pepiuspl/ArduinoR4wifi-Access-control/(commit log)

2026-05-26 Add access control sketch for Arduino IoT Cloud
2026-06-10 Added arduino-cli library index initialization step
2026-06-12 improvements, email reset logic rework
    [access_control.ino]
2026-06-12 File name .bin correction
    [access_control.ino]
2026-06-13 OTA rework open lock app synchro rework
    [access_control.ino]
2026-06-14 ESP32 v2.9.6
2026-06-14 ESP32 cleaned up
2026-06-14 EPS32 new device assign logic correction
    [access_control.ino]
2026-06-14 v2.9.7 - Cloud Solution ESP32
2026-06-14 compile-ESP32 add
2026-06-15 compiler correct ESP32
2026-06-15 pin correct
2026-06-15 high low change relay pin
2026-06-15 pin correction relay
2026-06-15 rfid, relay rework
2026-06-15 OTA Rework password show
    [access_control.ino]
2026-06-17 Sprint: lock state fix, livelier buzzer, offline mode, OTA
    [access_control.ino]
2026-06-23 relay fix
2026-06-23 IO2 pin change
2026-06-23 high-low change relay
2026-06-23 output input correction low high correction
    [access_control.ino]
2026-06-23 relay debug
2026-06-23 relay fixes
2026-06-29 keypad debug + fix
    [access_control.ino]
2026-07-03 heartbeat buzzer//relay activate/deactivate
2026-07-03 regex pin correction
2026-07-03 JWT token regex logic correction
    PIN logic correction
2026-07-03 OTA logic rework -- status bar correction Possible update check rework
    [access_control.ino]
2026-07-03 relay correction
2026-07-03 relay rework
2026-07-04 relay pin change
2026-07-04 moving to domain, rate limits, NPM introduced, performance correction
    [access_control.ino]
2026-07-04 settings wifi change rework/debug
    [access_control.ino]
2026-07-06 log button + MAC
2026-07-08 pin display fix
2026-07-08 OLED PIN message correction
    [access_control.ino]
2026-07-10 relay change
2026-07-30 added schedule, rotation PIN, guest mode, expiry date PIN, multidevice operation
2026-07-30 Adjusting card template to fit PIN
2026-08-01 logs filtering, cards change, schedule of use for pin and cards
2026-08-02 deciding length opening // relay fix
    [access_control.ino]
2026-08-03 denied screen + red LED
2026-08-13 Adding teams tab in app, invitations logic, super-admin logic,naming devices, invitations via email and code, deleting current setup - purging the device
2026-08-13 LIttle FS introduction instead of EEPROM, data retention, prep for licensing
    [partitions.csv]
2026-08-17 RFID pin correction
2026-08-17 RFID correction, handshake poll time short
    [access_control.ino]
2026-08-17 rfid reading speed fix
    [access_control.ino]
2026-08-17 adding reset button
2026-08-17 api/data correction, release_id addition
    [access_control.ino]
2026-08-18 reading cards fix, schedule fix
    [access_control.ino]
2026-09-14 firmware: offline licence token (dormant), BOARD_PCB_REV02 build flag; licensekey.js moved to tools/
    - OFL1 signed licence token (parseLicenseToken/applyLicenseToken, NVS ctrlsec/oflic), OFFLINE_FREE_CARDS=2 enforced in saveNewCard, learning flow handles cap
    - BOARD_PCB_REV02: KP_COL3 on IO2 for the custom PCB rev 0.2 (default 0 = dev kit, IO12)
    - tools/licensekey.js: online codes + offline tokens (offline mode not sold since 2026-09-14); deploy.sh packs it from tools/
    - .gitignore: licence/firmware signing keys never in repo
2026-09-14 docs: documentation audit 2026-09-14 — legal docs, website and licensing model aligned with code
    - LICENSING §3.4: downgrade = deactivate excess cards/PINs per client choice, owner card never locked, 90 days then delete; §3.3 Gold monthly; §3.5 offline licence dormant (offline = free tier only)
    - README §3.7 limit enforcement, §5.12 dormant offline licence
    - privacy policy + terms: service access (48 h, on-site code), controller/processor roles, offline mode, retention 15/45/90, backups 30/90, OVH mail relay, EAS, in-app export/deletion, warranty 24/12, packages and expiry, OTA, UID cloning notice, art. 38(13) consent, ODR removed; pre-release note
    - website: cloud optional (online/of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
2026-09-14 docs+site: audit stages 2-4 — legal docs, website copy, README aligned with code
    - privacy policy/terms: roles, offline mode, retention 15/45/90 + 90-day credential hold, backups 30/90, OVH/EAS/NTP/GitHub processors, in-app export/deletion, warranty 24/12, packages, expiry, OTA, UID cloning, art. 38(13), ODR removed, pre-release note
    - website: pre-launch bar, online/offline positioning, Polish product, Node spec rebuilt around one-controller strengths + security card, packages as cards+PINs without device limit, company data on contact page
    - LICENSING §3.4 90-day deletion + reminders (to implement), §3.5 offline licence dormant, Gold monthly; README §3.1b/§3.2/§3.6/§4.1/§5.1b/§9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
2026-09-14 firmware: bump app_version to v3.2.0 (offline licence dormant, BOARD_PCB_REV02 flag, tamper comment)
2026-09-14 server: licence lifecycle — expiry reminders (T-7/T-1), 10-day deletion warning, delete package-locked credentials after 90 days
    - migrations: license_locked_at, license_delete_notice_sent (cards/PINs), license_notice_valid_until/stage (accounts)
    - enforceLicenseLimits stamps license_locked_at on lock, clears on restore
    - runLicenseLifecycle() daily: e-mail+push reminders, warning 10 days before deletion, delete after LOCKED_CREDENTIAL_DAYS (cards also get D|uid so the device forgets them); owner card/PIN never affected
    - docs: LICENSING §3.4, README §3.7/§3.2/§9
2026-09-14 firmware v3.2.1: boot diagnostics — reset reason, heap_min and core-dump backtrace in the boot log; WiFi modem-sleep off; .elf in release
    - esp_core_dump summary (task, PC, cause, 12-frame backtrace) appended to the [FS] boot line, dump erased after reporting
    - WiFi.setSleep(false)
    - CI attaches lock_<version>.elf; tools/decode_backtrace.sh resolves addresses via xtensa-esp32-elf-addr2line
    - README §5.13
    [access_control.ino]
2026-09-16 development build to determine the reason for self-resets
    [access_control.ino]
2026-09-16 breadcrumbs version, auto-reset debug
    [access_control.ino]
2026-09-16 v3.2.6: raport z crashu w RTC do skutecznego wysłania; licznik wczesnych crashów i powód resetu w linii bootu
    [access_control.ino]
2026-10-05 firmware v3.3.0: PIN-y offline, limity 500/500, rev 0.3 domyslna
    Klawiatura dziala bez Wi-Fi. Nowy modul pin_store.h/.cpp: /pins.db z hashami
    PBKDF2-HMAC-SHA256 liczonymi JEDNA sola urzadzenia (NVS ctrlsec/pinsalt,
    20 000 iteracji). Nie bcrypt jak na serwerze, bo bcrypt soli kazdy rekord
    osobno i sprawdzenie 500 kodow wymagaloby 500 pelnych przeliczen; jedna sol
    pozwala policzyc hash raz i porownac z kazdym rekordem w stalym czasie.
    Centralka egzekwuje lokalnie aktywnosc kodu, date waznosci, limit uzyc
    (licznik zapisywany na flash) i harmonogram; bez NTP odmawia (fail-closed,
    tak samo jak przy kartach). Osobny modul, bo Arduino generuje prototypy
    funkcji na gorze .ino, zanim pozna typ zdefin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
    [partitions.csv]
2026-10-05 licencje: pakiety 50/200/500 po podniesieniu sufitu sprzetowego
    Stara drabinka (Silver 10/10, Gold 50/50, Indywidualna 200) powstala przy
    sufcie 200 i przy zalozeniu, ze PIN-y offline nie dzialaja. Po v3.3.0 sufit
    to 500 kart i 500 PIN-ow, a PIN-y dzialaja lokalnie, wiec:
    Silver 50/50, Gold 200/200, Indywidualna do 500.
    Darmowy poziom bez zmian (2/2). Upsell zostaje na retencji logow, kodach
    goscinnych, liczbie adminow i centralek - nie na liczniku poswiadczen.
    Token licencji offline trzyma liczbe kart i PIN-ow w pojedynczych bajtach,
    wiec nie wyrazi wartosci powyzej 255: Gold sie miesci, Indywidualna powyzej
    255 wymagalaby nowej wersji formatu. Tryb offline jest uspiony, wiec zostaje
    to j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
2026-10-05 zmiany limitów
    to jako znany limit - udokumentowany, nie obejsciowy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
